USSTR-Avionics/MiniRockets/Software/CPP_flight_computer_program/PREFLIGHT_CHECKLIST.md

- [ ] Check orientation of sensors and correct configuration in code

- [ ] Run unit tests on OBC

- [ ] Commit and release package

- [ ] Run unit tests and upload to OBC

- [ ] Build code in production mode and upload to flight computer
