USSTR-Avionics/MiniRockets/Software/CPP_flight_computer_program/documentation/GLOSSARY.md

Apogee: 
    the highest point the rocket will reach

OBC: On Board Computer (used interchangeably with Flight Computer)
    The main microcontroller/computer that controls all the electronics on the rocket
