USSTR-Avionics/MiniRockets/(threads)

Thread 13 (2022-10-29):

statemachine vulnerability

snowy-shadow, 2022-10-29:
please replace the statemachine with a
```
namespace xyz
{
    enum class abc
    {
      states
    }
}
```
Always prefer enum class over enum

frroossst, 2022-10-29:
Will fix after migration to CPP is complete! And MVP code for a mini rocket is complete.

Expected completion date : 30 November 2022

frroossst, 2022-10-30:
Enum classes not supported by C!

Our cpp should maintain compatibility with core C, to keep the code portable for future micro controller changes. Might reopen this later.

snowy-shadow, 2022-10-30:
`enum` is supported by C. problem is
```
enum States
{
a,
b
}
```
`a == 0` is evaluated true, which is another vulnerability which `enum class` fixes
this means `if(states == a)` is the same as `if(states == 0)`

frroossst, 2022-10-30:
wouldn't this help solve the issue you mention? Now every state will be valid only once
```
 #include<stdio.h>

  enum state{Ground, Flight, Landed};

  int main()
  {
      enum state s;

      s = Ground;
      printf("%d \n",s);
      return 0;
 }

```

snowy-shadow, 2022-10-31:
that is the main idea yes. we want to only allow one state to exist at a time so
```
state
{
   state1,
  state2,
}
state s = state1;
func(s);
func2(s);
```
is one way to prevent having 2 states happening at the same time.
there are also fancier implementations that I've seen(with pointers and classes, for C, it would be with void ptrs and structs), but for our purpose it would suffice here i think.
I could look more into FSM designs since im also interested in using them in my own projects

frroossst, 2022-10-31:
I agree it is quite dumb to use a struct for the actual state than enum, as multiple states would not be valid at the same time, we can probably blame @djh293 for that lol

yes! and in our current design we can also conceivable set the wrong states
```
rocketstate.landed = true;
rocketstate.flight = true;
```
A simple error or oversight in copy pasting code would lead to some major problems

snowy-shadow, 2022-11-02:
I got the statemachine figured out, im going to start working on the statemachine if there are no other urgent tasks

this is the most elegent version of statemachine that I could find on the internet...

Here is the proof of concept:
https://godbolt.org/z/zonscWdPW

frroossst, 2022-11-02:
Hold off on it for now. Dylan and I have different priorities right now. We're working out some managerial kinks on the project.

Closed 2022-11-09.

Thread 16 (2022-10-31):

Fix .gitignore

frroossst, 2022-10-31:
This is my bad, I was dumb, my updated `.gitignore` was in `Avionics-code/CPP.....` while the top level directory was `Avionics-code/` I'll have to go in and `git rm <name>` things now.

The following is a thread documenting things we NEED to be ignored.

- Compiled Rust target binaries
- IDE specific folders (.vsc etc)

frroossst, 2022-11-01:
I have fixed this on my end.

Closed 2022-11-29.

Thread 18 (2022-11-02):

I got the statemachine figured out / Statemachine redesign / rewrite

snowy-shadow, 2022-11-02:
I got the statemachine figured out, allow me to fix our statemachine

this is the most elegent version of statemachine that I could find on the internet...

Here is the prototype:
https://godbolt.org/z/zonscWdPW

Closed 2022-11-02.

Thread 28 (2022-12-17):

Add code for I2C Thermocouple sensor

frroossst, 2022-12-17:
- Prototype by itself
- Add it to main() codebase

frroossst, 2023-02-05:
Intitial code: https://github.com/USSTR-Avionics/Avionics_code/pull/52

Closed 2023-02-12.

Thread 30 (2022-12-24):

Change (debug == true) checks to a defined macro

frroossst, 2022-12-24:
For optimal performance instead of doing a branched check we just do macro substitution using the pre-processor

```
// define a macro
#define println(a) Serial.println(a)

// write a debug print
println("Hello world!");

// disable the macro on production
#define Sprintln(a)

```

frroossst, 2023-01-16:
Only make these changes to the src/ folder

frroossst, 2023-01-16:
fixed with https://github.com/USSTR-Avionics/Avionics_code/tree/958f1e9244c95f15e3bb4d8336b7f7f4283a0771

Closed 2023-01-16.

Thread 31 (2023-01-15):

Add silk screen pin labels to the PCB

frroossst, 2023-01-15:
To easily identify pins that connect to the flight computer

frroossst, 2023-03-23:
Design was frozen, never implemented!

Closed 2023-03-23.

Thread 33 (2023-01-16):

Add diode and switch before power branches out to components

frroossst, 2023-01-16:
- To have a global switch to the entire system
- To prevent someone from plugging in the battery the wrong way around

Closed 2023-03-23.

Thread 34 (2023-01-16):

RFC 202301181937: Resume state on software crash

frroossst, 2023-01-16:
The rocket if the software crashes should resume in the state it was last in, or implement a recovery mode

frroossst, 2023-01-19:
# Abstract

If the rocket's software crashes, how do we ensure it picks up or resumes the state machine from
the position it left it in. We cannot restart as if software crashes on ballistic descent, and we
restart from ground idle then we'll never transition forward and ever reach parachute deploy, due
to how the parameters in the state machine handle transitions.

# Stakeholder(s)

Avionics

# Problem

If the rocket's software crashes, how do we ensure it picks up or resumes the state machine from
the position it left it in. And to resume and ensure a successful flight.

# Solution(s)

## Store the state in the FRAM

Store the state in a single byte on the FRAM after every transition and pickup state from where it
crashed.

## Enter a software recovery or safe mode of sorts

On watchdog timeout simply enter a safe mode where the rocket enters a recovery or safe mode where
it only focuses on the essential software tasks, such as deployment of the recovery system, and nothing
more, may send a panic!() radio signal to the ground station.

# Difficulties and Risks

## Store the state in the FRAM

The potential problem with this is if the software crashes after a state transition but
before a successful FRAM write then we're stuck in a state from which we cannot get out of. Another
problem is that we may not have a solid I2C bus to the FRAM, so we may not be able to write to it or
loose it mid-flight. This also puts a single point of failure on the FRAM.

## Enter a software recovery or safe mode of sorts

This is a more complicated solution, but it would allow us to recover from a software crash and
resume the state machine from where it left off. This would require a lot of work and testing to
ensure that we can recover from any state and resume the state machine from where it left off. We
need to ensure that the recovery system doesn't have a single point of failure, for example, what
would we do if the barometric sensor(s) fail. Refer to [RFC: Sensor redundancy](https://github.com/USSTR-Avionics/Avionics_code/issues/36)

# Estimated costs and timelines

There should be no cost associated with this, as it is a software solution.

Timeline for solution 1 is a couple of days at best, while solution 2 may require a couple of weeks
as we haven't yet been able to configure the watchdog timer to trigger a reset on time.

# Proof of Concept

Not Applicable

# Testing and Robustness assurance

test, Test, TEST, T E S T !

# References
Not Applicable

casey-SK, 2023-01-21:
You need to be careful to ensure the correct state is entered. Gotta make sure you don't ignite the rocket motor at an unsafe time just because the software previously crashed. If the program crashes, I would probably not attempt to recover and put it in "super safe mode" where no code is allowed to execute, period.

The solution to this problem is have good coverage and anticipate all errors.

frroossst, 2023-01-21:
When the rocket first boots up, it enters an "unarmed stage" where it does nothing, literally nothing except wait for a radio signal from the ground telling it to arm itself, after it is armed, it can fire rocket motors and then it transition to powered flight -> unpowered flight -> ballistic descent -> parachute deploy -> land safe.

As for the rest, I can get you on speed tomorrow! :)

frroossst, 2023-02-19:
Already implemented software_recovery_mode in 28928d774e22ca764ae01d6f633a490f8b51f9ee

snowy-shadow, 2023-02-23:
```
void setup
{
rocket_state = eeprom.read(0x00)
}

void loop()
{
stuff
}
```
for each rocket statechange, write to the eeprom as in integer. Instead of `void recover()`, just get state from the eeprom everytime you run setup which would be run when the board crash

snowy-shadow, 2023-02-23:
https://www.pjrc.com/teensy/td_libs_EEPROM.html
teensy 4.1 have 4284 bytes of eeprom

Closed 2023-04-15.

Thread 36 (2023-01-16):

RFC 202301181940: Sensor redundancy/ Handle a mission critical sensor failure

frroossst, 2023-01-16:
Handle the failure of an acceleration sensor and a barometric pressure sensor

frroossst, 2023-01-19:
# Abstract

If the rocket's software crashes, how do we ensure it picks up or resumes the state machine from
the position it left it in. We cannot restart as if software crashes on ballistic descent, and we
restart from ground idle then we'll never transition forward and ever reach parachute deploy, due
to how the parameters in the state machine handle transitions.

# Stakeholder(s)

Avionics

# Problem

If the rocket's software crashes, how do we ensure it picks up or resumes the state machine from
the position it left it in. And to resume and ensure a successful flight.

# Solution(s)

## Store the state in the FRAM

Store the state in a single byte on the FRAM after every transition and pickup state from where it
crashed.

## Enter a software recovery or safe mode of sorts

On watchdog timeout simply enter a safe mode where the rocket enters a recovery or safe mode where
it only focuses on the essential software tasks, such as deployment of the recovery system, and nothing
more, may send a panic!() radio signal to the ground station.

# Difficulties and Risks

## Store the state in the FRAM

The potential problem with this is if the software crashes after a state transition but
before a successful FRAM write then we're stuck in a state from which we cannot get out of. Another
problem is that we may not have a solid I2C bus to the FRAM, so we may not be able to write to it or
loose it mid-flight. This also puts a single point of failure on the FRAM.

## Enter a software recovery or safe mode of sorts

This is a more complicated solution, but it would allow us to recover from a software crash and
resume the state machine from where it left off. This would require a lot of work and testing to
ensure that we can recover from any state and resume the state machine from where it left off. We
need to ensure that the recovery system doesn't have a single point of failure, for example, what
would we do if the barometric sensor(s) fail. Refer to [RFC: Sensor redundancy](https://github.com/USSTR-Avionics/Avionics_code/issues/36)

# Estimated costs and timelines

There should be no cost associated with this, as it is a software solution.

Timeline for solution 1 is a couple of days at best, while solution 2 may require a couple of weeks
as we haven't yet been able to configure the watchdog timer to trigger a reset on time.

# Proof of Concept

Not Applicable

# Testing and Robustness assurance

test, Test, TEST, T E S T !

# References
Not Applicable

frroossst, 2023-01-19:
# Abstract

Handle the failure of a mission critical sensor, off the top of my head acceleartion and barometric
sensor failure would be the most critical.  The system should be able to reliably state transition
and/or deploy the recovery system.

# Stakeholder(s)

Avionics

# Problem(s)

How do we know
a) the values from the sensor are valid and reliable in refernece to the environment
b) recover from a sensor failure or a failure to communicate, or loss of sensor data

# Solution(s)

a) use multiple sensors and compare the values

b) Kalman filter to estimate the state of the system

c) use a sensor fusion algorithm to combine the sensor data

d) in case of complete sensor failure?!

Looking for feedback!

# Difficulties and Risks

a) how to select the correct sensor reading when multiple sensors report different values

b) how to implement and test the validity of the Kalman filter

c) how would we even go about doing this?

d) I think we just give up at this point.

# Estimated cost(s) and timeline(s)

with research and development and standard USST work hours we're looking at a 4-6 weeks, at least.

# Proof of Concept

Not Applicable

# Testing and Robustness Assurance(s)

Looking for feedback!

# Reference(s)

Not Applicable

snowy-shadow, 2023-01-19:
Im proposing
3 sensors, after applying EMA on each values, make sure they lie within a certain % of each other. The one that doesn't gets a strike and is excluded in the currently calculation.
If accumulated a certain amount of strikes within a certain period, the sensor is deemed broken and ignored or turned off
else the strike is reset

frroossst, 2023-01-19:
Would we have 3 different sensors? or 3 of the same kind?
- I feel 3 of the same makes more sense, as if they are from the same manufacturer then we can eliminate a lot of variables between ICs, manufacturers etc.

How would we go about determining that margin of error percent?
- Off the top of my head, a lot of trial and error is what comes to mind. It'll be a balancing act for sure

snowy-shadow, 2023-01-20:
1. 3 of the same sensor would be the bare minimum for detecting if 1 of the sensor is faulty
2. Yes, trial and error honestly

frroossst, 2023-01-20:
Let's say we mark a sensor as faulty, so now we're working with 2/3 sensors (this is assuming we have implemented the 3 strikes system to increase our odds of NOT getting a false positive), now working with 2 sensors, what if we get a discrepancy then, i.e. our two remaining sensors don't align. Would we get an input from the sensor we marked supposedly "faulty" to see which of our two current sensor is giving us a value that might be closer to the actual reading. Or would we enter a loop where we take the readings again 3 times and compare, if all 3 readings are outside a margin of error, we declare acceleration sensors as bonked and enter a state or solution that would be implemented in RFC https://github.com/USSTR-Avionics/Avionics_code/issues/34

Now admittedly this is a rare issue, that we would not be encountering on the actual flight, but just something we should discuss and think about before we move on with a potential implementation

casey-SK, 2023-01-21:
I enjoy this thought experiment and would also be proud to have developed such a robust system. However, I don't believe sensor redundancy is required for this project.

Correct me if I am wrong, but the goal of the Rocketry team is to launch a single stage solid rocket to >10,000 ft ? I think there is a payload requirement, or is the payload optional?

Anyways, After igniting the solid rocket motor, the avionics only really has 3 vital jobs

1. Measure altitude and store that value. (we don't even technically need all the values, we only need to know the apogee)
2. Deploy the parachute on decent
3. Emit a recovery signal so we can recover the rocket

Obviously, we will be doing a lot more than this, but it is important to remember the KISS principle.

Getting back to the sensor redundancy, only one sensor is vital and the rest are 'bonus': Pressure. At a bare minimum, we can use the [NOAA](https://en.wikipedia.org/wiki/Pressure_altitude) formula to estimate the altitude. Provided the sensor has been tested before launch day, it is highly unlikely it will fail to provide a result. Just as critical as the sensor is the storage. Are we gonna propose redundant storage as well? How many cpu cycles do we got to spare to do multiple writes?

I am just walking in the door, so I don't know this, but I am assuming our avionics will include a GPS module onboard? We can use that to back up the claims made by our pressure sensor or trust the data in the absence of the pressure data if it were to fail.

Additionally, we could use radio time of flight to get a range as well, with a little help from our friend Pythagoras we can derive altitude. So we now have 3 methods to come up with an altitude reading without adding more sensors on board.

Cheers.

djh293, 2023-01-21:
There is a valid justification for implementing redundant sensors given in Launch Canada's Requirements that we need to be designing towards:

"Launch vehicles shall implement completely independent and redundant recovery systems,
including:
• Arming switch
• sensors/flight computers
• power supply
• energetics
• ""electric initiators"""

With that being said, the purpose of the first mini-rocket test launch is to demonstrate a minimum viable product (MVP) witch has only 2 vital jobs mentioned above for the mini-rockets:
1. Detect apogee
2. Deploy the parachute

With the KISS principle in mind, I believe as long as we thoroughly test the sensor on the ground, we do not have a high risk of losing that data.

Therefore, for this first MVP launch, we should only have one thoroughly tested sensor. For Launch Canada this should be discussed further.

Closed 2023-04-15.

Thread 37 (2023-01-18):

Figure out a testing (unit/integration) framework for testing the whole system including the hardware

frroossst, 2023-01-18:

casey-SK, 2023-01-21:
https://docs.platformio.org/en/latest/advanced/unit-testing/index.html#unit-testing

frroossst, 2023-01-21:
Our problem is that we can't really run the code that interfaces with the hardware on our machines without the actual hardware.

For example how would we go about, testing the acceleration sensor works correctly.

casey-SK, 2023-01-21:
I  would perform a resistance test to ensure all pins work on a given IC, perform a bench test on an apparatus where you can control the parameter in question (a drop test for the linear acceleration example, comparison test for most other sensors), and use a debugger probe to to test the code in situ.

frroossst, 2023-01-21:
Perhaps we can lay this test plan out tomorrow! And get onto laying out procedures on how to perform them and building apparatus to test our systems. I was looking at mainly software solutions like fuzz testing perhaps cause software is what I'm most familiar with.

frroossst, 2023-01-21:
Haven't looked into this a lot, but I'll try to get a proof of concept up and running by next week, we could using an additional micro-controller hijack the I2C lines and emulate the data received from the sensors, this would allow us to test a variety of scenarios really quickly and make fuzz testing fairly simple too.

frroossst, 2023-03-23:
Moved to the Delisle project!

Closed 2023-03-23.

Thread 38 (2023-01-18):

[Example] RFC: Why not just make a nuclear missile?

frroossst, 2023-01-18:
*This is an example RFC, we're not actually gonna build a nuclear missile*

# Abstract

Instead of making a model rocket going 30,000 feet, we could just make a nuclear missile

# Stakeholder

Propulsion, Avionics, Aerostructure, P&E, Payload

# Problem(s)

Not Applicable/ Looking for comments

# Solution

Not Applicable/ Looking for comments

# Difficulties and Risks

- Thrust Vector Control and control surfaces
- Nuclear payload development
- Procurement and enrichment of uranium
- Disposal of nuclear waste
- No one on the team is a nuclear physics expert or remotely capable on the subject

# Estimated costs and timelines

A couple of billion dollars and about 30 years

# Proof of concept

The government told us to redact this part

# Testing and robustness assurance

Looking for comments

# References

Not Applicable

Closed 2023-04-15.

Thread 48 (2023-01-29):

[Thread] Sensors are giving out garbage values

frroossst, 2023-01-29:
I was testing the Teensy with only the BMP280 and KX134 and the sensors are giving out garbage values, am figuring out if it is a Teensy issue, a sensor issue or a code issue. Most probable is a sensor issue, but they're new so ¯\_(ツ)_/¯

ping: @djh293

frroossst, 2023-01-29:
I2C Scanner says no I2C devices found.

```
Unknow error at address 0x01
Unknow error at address 0x02
Unknow error at address 0x03
Unknow error at address 0x04
Unknow error at address 0x05
Unknow error at address 0x06
Unknow error at address 0x07
Unknow error at address 0x08
Unknow error at address 0x09
Unknow error at address 0x0A
Unknow error at address 0x0B
Unknow error at address 0x0C
Unknow error at address 0x0D
Unknow error at address 0x0E
Unknow error at address 0x0F
Unknow error at address 0x10
Unknow error at address 0x11
Unknow error at address 0x12
Unknow error at address 0x13
Unknow error at address 0x14
Unknow error at address 0x15
Unknow error at address 0x16
Unknow error at address 0x17
Unknow error at address 0x18
Unknow error at address 0x19
Unknow error at address 0x1A
Unknow error at address 0x1B
Unknow error at address 0x1C
Unknow error at address 0x1D
Unknow error at address 0x1E
Unknow error at address 0x1F
Unknow error at address 0x20
Unknow error at address 0x21
Unknow error at address 0x22
Unknow error at address 0x23
Unknow error at address 0x24
Unknow error at address 0x25
Unknow error at address 0x26
Unknow error at address 0x27
Unknow error at address 0x28
Unknow error at address 0x29
Unknow error at address 0x2A
Unknow error at address 0x2B
Unknow error at address 0x2C
Unknow error at address 0x2D
Unknow error at address 0x2E
Unknow error at address 0x2F
Unknow error at address 0x30
Unknow error at address 0x31
Unknow error at address 0x32
Unknow error at address 0x33
Unknow error at address 0x34
Unknow error at address 0x35
Unknow error at address 0x36
Unknow error at address 0x37
Unknow error at address 0x38
Unknow error at address 0x39
Unknow error at address 0x3A
Unknow error at address 0x3B
Unknow error at address 0x3C
Unknow error at address 0x3D
Unknow error at address 0x3E
Unknow error at address 0x3F
Unknow error at address 0x40
Unknow error at address 0x41
Unknow error at address 0x42
Unknow error at address 0x43
Unknow error at address 0x44
Unknow error at address 0x45
Unknow error at address 0x46
Unknow error at address 0x47
Unknow error at address 0x48
Unknow error at address 0x49
Unknow error at address 0x4A
Unknow error at address 0x4B
Unknow error at address 0x4C
Unknow error at address 0x4D
Unknow error at address 0x4E
Unknow error at address 0x4F
Unknow error at address 0x50
Unknow error at address 0x51
Unknow error at address 0x52
Unknow error at address 0x53
Unknow error at address 0x54
Unknow error at address 0x55
Unknow error at address 0x56
Unknow error at address 0x57
Unknow error at address 0x58
Unknow error at address 0x59
Unknow error at address 0x5A
Unknow error at address 0x5B
Unknow error at address 0x5C
Unknow error at address 0x5D
Unknow error at address 0x5E
Unknow error at address 0x5F
Unknow error at address 0x60
Unknow error at address 0x61
Unknow error at address 0x62
Unknow error at address 0x63
Unknow error at address 0x64
Unknow error at address 0x65
Unknow error at address 0x66
Unknow error at address 0x67
Unknow error at address 0x68
Unknow error at address 0x69
Unknow error at address 0x6A
Unknow error at address 0x6B
Unknow error at address 0x6C
Unknow error at address 0x6D
Unknow error at address 0x6E
Unknow error at address 0x6F
Unknow error at address 0x70
Unknow error at address 0x71
Unknow error at address 0x72
Unknow error at address 0x73
Unknow error at address 0x74
Unknow error at address 0x75
Unknow error at address 0x76
Unknow error at address 0x77
Unknow error at address 0x78
Unknow error at address 0x79
Unknow error at address 0x7A
Unknow error at address 0x7B
Unknow error at address 0x7C
Unknow error at address 0x7D
Unknow error at address 0x7E
No I2C devices found
```

frroossst, 2023-01-29:
Apparently using the ground pin on the right hand side while also having 3v3 and 5v plugged in doesn't work?! and you need to use the ground on the other side of the board, this stops the unknown error warnings, but still no I2C devices show up

frroossst, 2023-01-30:
After some panic, I think I know what went wrong here, will do more testing and confirm by EOD

frroossst, 2023-01-30:
Sensors work as intended, false alarm.

Didn't solder the power and I2C pins properly on the teensy, smh.

Closed 2023-01-30.

Thread 53 (2023-02-05):

RFC 202302061040: Communication Between Systems

dhaussecker, 2023-02-05:
# Abstract
We need to come to a conclusion about a communication method for our systems to talk to each other. There are multiple serial communication methods that could be utilized: Some popular ones that always come up are I2C, SPI, and CAN. What's best and what should we choose?

# Stakeholder(s)

Avionics
Propulsion
Aerostructure
Systems

# Problem(s)

We need to decide on a communication protocol to be used across systems in the rocket

# Solution(s)

a) I2C
Requires one specific device to be the master.
Lines: 2 lines [SCK and SCL]
Speed: 100kbps
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

b) SPI
Requires one specific device to be the master
Lines: 4 lines [MISO, MOSI, SCK, CS], Must add extra CS for each additional sensor
Speed: up to 10Mbps
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

c) CAN
In CAN each node can behave as Master or Slave. Has a device/message priority system.
Lines: 2 Lines[TX and RX]
Speed: up to 1 Mbit/s
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

d) Other Communication Methods (Ethernet, Fiber Optic, USB, UART)
- Make a proposal if you can think of any other options

Looking for feedback!

# Difficulties and Risks

a) Need to decide what method will be best for us

b) I2C is not at all the way to go for long distances. CAN transceivers or RS485 used with normal UART is a robust solution. I2C is designed to be used in-PCB so max distance shouldn't exceed 50 cm. SPI's maximum distance is about 10m. CAN's max distance is about 1km

c) SPI wiring gets more complex for each new sensor you add in as each sensor requires one new wire, wire I2C and SPI don't.

d) SPI can't acknowledge that data has been successfully received (I2C and CAN have this)

c) Multiple student rockets are using CANbus for their systems, making it seem like a good way to go, but I don't want to just jump into it without other input.

# Estimated cost(s) and timeline(s)

This system would be integrated in all board and software designs throughout this year.

# Proof of Concept

Check references for Uwaterloo's CANbus architecture

# Testing and Robustness Assurance(s)

Looking for feedback!

# Reference(s)

https://drive.google.com/open?id=169TVnTIVYmfNrPiK4FvcD331LEPFN7fr&disco=AAAAm5xzJQI

frroossst, 2023-02-05:
We have I2C and SPI sensors, how would we convert them to the CAN protocol? Are there sensors that are CAN compatible already which we can use? How complex is the process of converting from (I2C, SPI) to CAN.

Before making the decision, we should convert the basic groupings of sensor, (BMP280, KX134, FRAM) and use them over CAN with the Teensy as a proof of concept.

If CAN turns out to be expensive in terms of time, energy and code  to implement, could we feasibly use CAN for sensors that require long distance communication and I2C for others?

djh293, 2023-02-06:
This discussion mainly revolves around communications between systems, and by between systems, I mean between our boards. Note, this does note include communications within each board.

All the sensors mentioned above will still use I2C or SPI, weather to use  I2C or SPI within the board should come down to what is deemed the most critical, and could be a further discussion (SPI is faster than I2C). CAN-bus would only be used to communicate from board to board using a CAN transceiver hooked up to the microcontroller on the board.

See the photo of the proposed gps board as an example as it has the proposed CAN-transceiver:
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

frroossst, 2023-02-06:
So, if I understand this correctly, then CAN would be used for let's say communicating between the microcontroller on the GPS board, the microcontroller on the RF board, and let's say the main microcontroller? Wouldn't this mean that a microcontroller is required on every individual/ modular board we add to the mix? Does this no unnecessarily raise the complexity of the system? Why add one more serial communication interface? (except maybe the distance issue with I2C and SPI)

djh293, 2023-02-06:
This is a 10 foot tall rocket we are talking about. There is going to be a need for some boards to be closer to one side of the rocket than the other.

Also it does not complicate the problem in my opinion, it simplifies it. All systems are now on their own individual board. It would be a nightmare if you had to redo a whole entire board when all you needed is to add one extra part. Also, one microcontroller for everything is not feasible for the amount of wires that would have to be running to it for every single sensor. Serial communication just simplifies the problem by allowing that data to be transferred over 2 wires instead of let’s say 100. A single microcontroller controlling every single subsystem would very quickly become an issue

frroossst, 2023-02-06:
I think the different board and communication arguments make sense. I think the modularity would be a huge boon in the long term, it also allows some boards to be asynchronous if we have a datalogger board that just listens to I2C signals on a line then it wouldn't be "blocking" the main flight computer and doing this with other boards would also free up the main loop() and make it faster, just a few clarifying questions though, would we standardise what microcontrollers are used across different baords or would that be left to the board designers? I think it should be left to board designers, for example the GPS board would definitely need hardware float support, whereas the FRAM board doesn't necessarily need as powerful a computer on it's module board. Also, are we concerned about the delay that is added by introducing a microcontroller in the middle?

Current: `main micro-controller` -> `sensor`
Planned: `main micro-controller` -> `modular micro controller` -> `sensor`

djh293, 2023-02-07:
I am not concerned with any sort of delays, sensors go to their mcu on the board then straight to CAN, that’s actually going to make things faster than using 1 mcu for everything. Mcu type would will likely be standardized (for example we will be testing out STM32’s) but particular mcu part numbers could be modified for certain applications.

frroossst, 2023-02-07:
I only mention the slowdown because if you were building a self-driving card having a central powerful gpu is more faster and efficient than having multiple gpus process at the sensors before they reach the main micro-controller. Are we concerned about the costs? For some applications the standard mcu might be overkill and not worth the cost? Is there an actual difference in the amount of money these different mcus cost?

djh293, 2023-02-07:
Our standard mcu is only $5, so I’m not concerned about the cost (other options could range between $1-$20. We not planning to  design the fastest system on the planet so there is no need to optimize the system to be as fast as possible, although I see no risk in slowing down speeds anyways.

frroossst, 2023-02-07:
If that's the case then, I don't see any problems at least now, that might arise from this implementation.

Closed 2023-04-15.

Thread 57 (2023-02-18):

Fix blocking code in main program

dhaussecker, 2023-02-18:
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
Please fix the following lines of code to have a non-blocking implementation

frroossst, 2023-02-18:
I don't get paid enough to deal with this shit

frroossst, 2023-02-18:
How do we ensure non blocking implementation of the above, does not break soft_recovery_mode()

https://github.com/USSTR-Avionics/Avionics_code/blob/239cbfb9d4ad30f8ef577375a49e0b4af8b44a7f/CPP_flight_computer_program/src/main.cpp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

frroossst, 2023-02-22:
|      data            |   size    | data type |
|----------------------|-----------|-----------|
| time                 | 04 bytes  | u32       |
| rocket state         | 01 byte   | u8        |
| acceleration x axis  | 02 bytes  | float16   |
| acceleration y axis  | 02 bytes  | float16   |
| acceleration z axis  | 02 bytes  | float16   |
| gyroscope x axis     | 02 bytes  | float16   |
| gyroscope y axis     | 02 bytes  | float16   |
| gyroscope z axis     | 02 bytes  | float16   |
| relative altitude    | 02 bytes  | float16   |
| pressure             | 02 bytes  | float16   |
| thermocouple temp    | 02 bytes  | float16   |
| extra space          | 02 byte   | undefined |
| total                | 25 bytes  |           |

> I've used collect and store interchangeably here, please note, collection here refers to collection to the fram i.e. storage to the fram

Say, this is what one sensor chunk looks like, takes up 25 bytes, 2 bytes are reserved for whatever extra data that we might need to store in the future, maybe payload info, or thermocouple internal temperature or anything really, I've kept it as 2 bytes (could be more).

Now our fram can store 32Kbyte(s) which is 32,000 bytes. now, one chunk of data is 25, so we'll be able to write $$32,000/25 = 1,280$$

So, we can write to one FRAM 1280 chunks of data. so far so good.

If we write 1 chunk per second, we'll be able to collect data for 1280 seconds which is 21.33 minutes.

But, as the preliminary testing over discord the other day suggested, our loop() executes about 500 times in every other state with the exception of the aforementioned state (~2) and ground_idle (>2000).

Now, even if I were to assume that we're collecting data 250 times a second which is half of what the expected tick rate for loop() is, we'll be able to collect 5 seconds worth of data.

Assuming we're collecting data every 100 times a second, which is 20% of the nominal loop() tick rate, we'll be able to collect 12.8 seconds worth of data

Assuming we're collecting data 2 times a second, this gives us 640 seconds worth of flight data, which is roughly 10 minutes, if we double to rate i.e. collect data 4 times every second, gives us 5 minutes or so of flight data.

Now, a simple solution is to add more FRAM if you want to keep up the high tick rate of data collection *cum* storage, you'd need to have **60 FRAMs to store about 5 minutes worth of data, at a tick rate of 250 per second**, so naturally the other solution is to slow down the tick rate, by how much you might ask? well, about 2 per second, would be my recommendation, strikes a balance between the data we collect, and the storage we have without needing to add additional storage. And this "blocking" loop accommodates that requirement with zero modifications.

---
So, the conclusion is I will not be modifying this specific part of the code to be non-blocking for the time being and with the current hardware limitations, as under no circumstances at least with respect to data collection can this be considered ''blocking", if someone has a better argument apart from ''we need data in the meanwhile" which as demonstrated above is a fairly smooth brained take, and "while true bad" which demonstrates a lack of understanding of how code actually works and interacts with the system at large, if your argument is "we need the data for *something*" then I need to see a MVP or proof of concept of that *something* that you're referring to, making premature optimizations for phantom *somethings* is NOT something we should be wasting our time on.

If you have other arguments then please leave them down below in the thread!

dhaussecker, 2023-02-23:
"as under no circumstances at least with respect to data collection can this be considered blocking"
With respect to data collection, this may be true it's not going to impact us, but to respect to the whole entire system, it's going to impact us long-term.

Blocking code will make it EXTREMELY difficult to expand our system in the future, and I guarantee you this if you're writing not proper code right now with your excuse being "we don't need it right now" it will have to be rewritten in the future and waste more time.

There is an easy way to fix this, just use the same implementation we are using with tracking time using millis(), to remove the blocking part of the code. This is an easy fix, it will impact a few other functions that you will have to take into account but it is better than impacting 100 functions down the road when you realize your blocking code is holding you back a year from now. If you don't get to this, I'll fix it within the next couple of weeks.

"Write proper code now, so you do not have to 1 year from now" -Dylan ;)

frroossst, 2023-02-23:
I'm upset cause your whole argument was data collection :sob: :sob: :sob:

Blocking code is problematic if and only if you need to be doing something in the meanwhile, which we are not (right now), in the future perhaps, but like, what even would we be doing? We'll get to this when we do radio integration (even then we might not need to)

dhaussecker, 2023-02-23:
The fix for this will take 20 minutes, yet this discussion has taken multiple hours. Let’s just fix it when we have the time

frroossst, 2023-02-23:
Because it very much matters the path you take to a solution on a team project, as the "true" intentions might be masked behind a bs reason.

For example, the decision to switch from I2C to CANbus, could be justified as speed restrictions of I2C and it would be a perfectly reasonable explanation, but, the actual reasoning is length restrictions of I2C and the increased flexibility with CANbus with priority queues.

If someone is referencing these threads in the future, we're providing them with not actual truths behind our decisions, and if not for future-proofing we're propagating falsities through the team. This just creates a bad habit which'll result in something catastrophic down the line, let's say like buying a 20,000 dollar camera which does not work with the OBC 0_o

dhaussecker, 2023-03-08:
Code is still blocking, removing the while true in apogee check will conics me it is not

frroossst, 2023-03-08:
technical analysis of the impact or it didn't happen!

Closed 2023-04-15.

Thread 65 (2023-03-12):

Setup a remote dev workflow for devs to run code and unit tests remotely

frroossst, 2023-03-12:

snowy-shadow, 2023-03-13:
should we merge this with the ducklake proj? Both needs a server connection, and will read from the serial port. Both will need a webpage front end, and we might as well include a simple login to avoid random people visiting the site and taking over the arduino.

frroossst, 2023-03-13:
Yes and no.

Yes, because of all the reasons you mentioned

No, because DuckLake if things pan out wouldn't end up requiring a server, that whole setup was a little too much, PlatformIO has some remote development workflows we might end up going with that rather than building some infra ground up. (although would love to do that) now, we'd probably end up making some sort of credential manager to avoid people running random code on our remote dev servers.

We basically have three projects as of now:
| Project Name | Description | Priority |
|--------------------|----------------|------------|
| Duck Lake | Visualise Rocket Data | Low |
| Esterhazy|  Remote dev/ run tests | Moderate |
| Delisle | Software in the Loop tester | High |

We'll work on Delisle to get the whole software in the loop system going and then work on Esterhazy to use the whole system remotely, we might be able to do some Esterhazy work and then add on more features later, and Duck Lake will be very low on our list, as I cannot find someone to write some React code as of now.

snowy-shadow, 2023-03-13:
Thats great news! I just googled platformio remote dev and it seems super easy to setup (fingers crossed)

frroossst, 2023-03-23:
Moved to the [Esterhazy](https://github.com/USSTR-Avionics/Esterhazy) project

Thread 70 (2023-04-01):

The Future of Aviation: Why Rewriting Our Avionics Codebase in Rust is Essential for Success

frroossst, 2023-04-01:
Ladies and gentlemen, gather 'round and brace yourselves for the most audacious, grandiloquent, and downright impressive proposal you will ever encounter. Today, I present to you a compelling case for rewriting our avionics codebase in Rust, a language so cutting-edge it would make Elon Musk himself drool with envy.

Now, I know what you're thinking. "Why fix something that ain't broke?" But hear me out, dear colleagues. Our current codebase may be functioning as intended, but it lacks the resilience, robustness, and performance necessary to keep up with the demands of modern avionics. It's time to step up our game and embrace a language that can handle the challenges of the future.

With Rust, we can achieve unparalleled speed and efficiency, thanks to its low-level control over system resources and memory management. No more will we be bogged down by the overhead of dynamic memory allocation and garbage collection. Rust's strict compiler checks ensure that we catch errors before they become disasters, and its unique ownership model prevents the dreaded bugs caused by dangling pointers and data races.

But that's not all, folks. Rust is designed for concurrency, making it the ideal choice for handling the multiple tasks and systems required for aviation. Its lightweight threads and fearless concurrency model allow us to tackle the complexity of modern avionics with ease. And don't even get me started on Rust's security features. With its built-in memory safety and protection against buffer overflows, we can rest assured that our codebase is resistant to cyber attacks and other malicious exploits.

Now, I know some of you may be thinking, "But what about the learning curve? Won't we have to retrain our entire team?" Fear not, my friends. Rust's syntax is easy to learn and understand, and its community is vibrant and supportive. We can even integrate Rust with our existing codebase, making the transition seamless and painless.

In conclusion, dear colleagues, we owe it to ourselves, our passengers, and the future of aviation to rewrite our avionics codebase in Rust. It's time to embrace the future, and Rust is the language that will take us there. So let's do this. Let's rewrite our codebase in Rust and take to the skies with confidence and pride.

dhaussecker, 2023-04-01:
Please fill out a project proposal if you are actually wanting to propose this. The core foundation of weather a project will be approved is the following: "do the simplest thing that can possibly work". If it is determined that this is not the simplest thing that could possibly work, it is not worth our time with our intense schedule coming up over the next year.

At this point I do not see any merit in porting over our entire codebase to Rust when we have something that already works. We are not trying to meet the needs of modern avionics, we are a student team trying to develop a whole entire system within a year. Our core principle is, to do the simplest thing that can possibly work to make this happen.

Project Proposal template can be found here: https://github.com/USSTR-Avionics/KnowledgeBase/wiki/Documentation-Templates#project-proposals

frroossst, 2023-04-02:
# Background and Motivation

Rust is an excellent choice for an avionics project because of its safety features and low-level control. In the aerospace industry, safety is critical, and Rust's ownership model and strong typing help avoid common programming errors such as null pointer de-references, buffer overflows, and data races that can lead to system crashes or vulnerabilities. Rust also has a small runtime footprint and can produce efficient code, which is essential for embedded systems with limited resources.

Furthermore, Rust's support for bare-metal programming makes it well-suited for avionics projects that require direct hardware access. Rust's syntax and semantics allow for low-level memory manipulation, and its zero-cost abstractions make it possible to write efficient code without sacrificing control.

#   Why is this valuable to work on?

Well, for so many reasons, firstly, it’s just more modern, modern c++ is nothing more than a hot pile of garbage over another hot pile of garbage. Don’t get me wrong, I love C and C++, and I will happily code in them over Java or Javascript. But, when we have a group of people working on performance critical and robust systems where we cannot ensure or assume that every member of the team knows what they are doing, we run into a problem. Now, this could very easily be solved, we just hire someone who does QA, well maybe not hire but just assign them the title, but even the best programmers are no match for the Rust compiler, which can within seconds tell you what you are doing wrong. And it tells you at compile time, meaning, with proper CI/CD (which is basically a compile check) it is impossible (literally!) to commit code to master that has memory bugs in it!

And as an additional bonus we have seen a massive push towards Rust from the industry, Rust has been voted the most loved language for the past 8 years [[1]](https://survey.stackoverflow.co/2022/#technology-most-loved-dreaded-and-wanted).

The build system or the lack thereof in C/C++, we may either end up making a complicated make file or use CMake neither one of which are very fun to use. We cannot sem-ver control the libraries that we use, right now we need to maintain an archive of the libraries we use in a .zip format, which is rather caveman-esque. With Rust, every crate (or library) lives on [crates.io](https://crates.io/) and follows a semantic versioning system, so no matter when you build or who builds, as long as they have this tiny little Cargo.toml file they will have the same features and functions.

C/C++ lies! What I mean is, Undefined Behaviour and implicit behaviour sometimes the language just does things without telling you. Note how I am able to cause an integer overflow with just a couple of lines of c/c++ code.
```
#include <stdio.h>

int main()
    {
    long long int x = 100000000000000;

    int y = x;

    printf("%lld\n", x);
    printf("%d\n", y);

    return 0;
    }
    // output
    /// 100000000000000
		/// 276447232

   ```

   Now watch what happens with Rust code,
```
fn main()
    {
    let x: u128 = 100000000000000;
    let y:u32 = x;

    println!("x = {}", x);
    println!("y = {}", y);
    }

// output
error[E0308]: mismatched types
 --> src/main.rs:4:17
  |
4 |     let y:u32 = x;
  |           ---   ^ expected `u32`, found `u128`
  |           |
  |           expected due to this
  |
help: you can convert a `u128` to a `u32` and panic if the converted value doesn't fit
  |
4 |     let y:u32 = x.try_into().unwrap();
  |                  ++++++++++++++++++++

For more information about this error, try `rustc --explain E0308`.
error: could not compile `hello` (bin "hello") due to previous error

```
Rust, literally doesn't let you compile!

You might say, "Oh, We're not that dumb, we would never make that mistake" welps, we literally made that mistake causing an integer overflow in the address while writing to the FRAM, [link](https://github.com/USSTR-Avionics/MiniRockets/blob/42a359b2a91f5a51b14c2c35613a7aa832788fcb/CPP_flight_computer_program/src/sensor_fram.cpp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)

And don't even get me started on the keywords, `static` and the scopes of variables, writing code shouldn't be this hard!

As one [redditor](https://www.reddit.com/r/rust/comments/bya8k6/programming_with_rust_vs_c_c/eqfd0xl/) put it,
> If you have a team of people working on C/C++ code you have to make sure they are all very experienced and very careful. When reviewing code you have to be extra detail-oriented, especially for junior folks. Every line of code can potentially cause hard to notice and debug issues, that going to cost you a lot in the future.
> When you have a team working on Rust, you can have bunch of "junior-devs", one senior-Rust dev, to help them out, put `#![forbid(unsafe_code)]` in each crate, and when reviewing code focus on higher-level problems instead of suspiciously staring at each line for UB. Rust compiler is working like free couch for all your devs. The productivity gains are enormous.

Onwards, to more horrible examples! So, at many places in the code base we return macros like EXIT_SUCCESS or EXIT_FAILURE, which I love cause sometimes my dumb brain just doesn't know if 0 is success or a failure or was it 1? ugh! so the macros help with readability, but you see, there is not check or guarantee that the upstream parent that calls on a function that returns EXIT_SUCCESS or EXIT_FAILURE checks if the function was successful or not, but we would NEVER do that I hear you say! welps, look at this [function](https://github.com/USSTR-Avionics/MiniRockets/blob/42a359b2a91f5a51b14c2c35613a7aa832788fcb/CPP_flight_computer_program/src/sensor_bmp280.cpp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) forget checking things upstream we don't even return an EXIT_FAILURE!!! So even if the function fails to do what it is supposed to, we will read it as a success. And check [this](https://github.com/USSTR-Avionics/MiniRockets/blob/master/Software/CPP_flight_computer_program/src/main.cpp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) out where we simply just don't check if the function was successful or not, The solution, Rust's Error and Result types!
```
fn might_fail() -> Result<u8, String>
    {
    Ok(1)
    }

fn main()
    {
    let result = might_fail();

    match result
        {
        Ok(value) => println!("Result is: {}", value),
        Err(error) => println!("Error: {}", error),
        }
    }

```
As you can see above, when you get a result, it is an enum, this enum needs to be explicitly checked for it's success or failure, otherwise, you guessed what happens! The compiler doesn't let you compile the code.

When working on complex systems with many moving parts, every little bit of help from the language helps, and if you haven't noticed, the error messages from the Rust compiler are so incredibly useful, not only do they tell you what you're doing wrong, but most often than not, they tell you how to fix it, wha-?

Furthermore, you can never segfault in Rust, every other c/c++ function, even those in the standard library can segfault.

> C makes it easier to shoot yourself  in the foot, C++ makes it harder but when you do, you blow your whole leg off, while Rust will gently put the gun's safety on, tuck you into bed and spoon you till your fall asleep

We can write perfectly safe C/C++ code but, it requires too much micro-management and hand holding of the programmers to ensure that, Rust allows us to offload all of that to the compiler. Sure, linters exist, but where ever there is a way to disable warnings, programmers will do so. We should build safety nets rather than guard rails.

And as the project gets larger it becomes out of hand to maintain it, with the lack of strong type system and type checking, it becomes so much more harder with the out of control number of include files, with Rust you just put a `pub` in front of the function, or struct. Rust's memory safety, type system, modularity, performance, and tooling make it more maintainable than C++ for large projects. By reducing the likelihood of common programming errors, Rust makes the code more predictable, easier to understand, and more efficient, which translates into lower maintenance costs over time.

# Documentation
## Tools that we will use
- Rust docs
- mdBook for further detailed documentation

## What we will document
1.  System architecture design
2.  Design decisions and trade-offs
3.  Implementation details
4.  User documentation

# Scope
I will concede that a [RIIR](https://transitiontech.ca/random/RIIR) of the whole entire code base is unnecessary and unfeasible, and in an ideal world, I would want the Rust code to be the base from which we cross the FFI boundary to interact with lower level hardware. But, an even better approach is to continue writing our code base in C/C++ while we port parts of it to Rust, things that are fairly stable and not likely to change, for example we could re-write the CAN interface in Rust, or the FRAM interface, or parts of the code base that are mission critical could be Rusty. I personally do not expect anyone to code in Rust or even learn it. But in the grand scheme of things, as more embedded resources become available, Rust is going to be the obvious choice, not to mention the increased adoption in the industry.

# Timeline
The timeline for this project will be as follows:

Week 1-2: Background research and scope definition.
Week 3-4: Define preliminary requirements and identify potential stakeholders.
Week 5-6: Create a detailed project plan and cost analysis.
Week 7-8: Design and implement the system's core features.
Week 9-10: Develop and conduct tests to ensure the system's safety and reliability.
Week 11-12: Document the system's architecture, design decisions, and implementation details.
Week 13-14: Finalize documentation, prepare the project for deployment, and conduct user acceptance testing. Week 15: Deployment and project review.

# Limitations
Some of the potential challenges and their possible solutions are:

1.  Learning curve: Rust has a unique syntax and memory management model, which can be challenging for newcomers. To overcome this challenge, the team can allocate some time for Rust learning sessions, where experienced Rust developers can provide tutorials or code reviews to help new team members get up to speed with the language.

2.  Debugging: Rust is known for its strict compile-time checks, which can help catch bugs before the code runs, but it can also make debugging more challenging. To address this challenge, the team can use Rust's debugging tools, such as gdb and lldb, and use logging and assertions to help identify and fix bugs.

3.  Limited libraries and frameworks: Rust is a relatively new language, and it may not have as many libraries and frameworks as other languages like C++ or Python. To mitigate this challenge, the team can leverage the existing Rust libraries and frameworks, and also consider building custom libraries or modules if needed.

4.  Team communication: If not everyone in the team is familiar with Rust, it may lead to communication challenges during development. To overcome this challenge, the team can use collaboration tools like GitHub, Slack, or Discord to ensure effective communication and knowledge sharing.

5.  Code review and quality assurance: As Rust is a safety-critical language, it's essential to ensure that the code meets high quality and safety standards. The team can implement code review processes, use static code analysis tools, and conduct rigorous testing to ensure that the system is safe and reliable.

In summary, while not everyone in the student-led group may be familiar with Rust, the team can overcome the challenges by dedicating time to Rust learning, using debugging and testing tools, leveraging existing libraries and frameworks, ensuring effective communication, and implementing quality assurance processes.

# Conclusion
The proposed project aims to build a flight computer for a small sounding rocket using the Rust programming language. The use of Rust in avionics projects can provide safety, low-level control, and efficient code generation. The project has the potential to produce a reliable and robust flight computer system, reducing the risks associated with spaceflight activities. The Rust language's safety features, ownership model, and strong typing can help avoid common programming errors, such as null pointer dereferences, buffer overflows, and data races, which can lead to system crashes or vulnerabilities. Furthermore, Rust's support for bare-metal programming makes it well-suited for avionics projects that require direct hardware access. The project's success can also help promote the use of Rust in the aerospace industry, where reliability and safety are critical concerns.

frroossst, 2023-04-02:
I would also like to add, that we could, do the functional or business logic in Rust, while reserving C/C++ for hardware access.

frroossst, 2023-04-02:
Just look at our current statemachine, it is so incredibly easy to get it wrong, you must break or return the control flow in every case of the switch case statement, this is so easy to miss that it is classified as a common vulnerability by the [common weakness enumeration org](https://cwe.mitre.org/data/definitions/484.html), and I don't feel like opening my 214 textbook, but a missing break (or might've been a missing default clause regardless the point still stands) caused a telecom company in the 90s, millions of dollars.

Look at this code, there is no check on the value that can be passed to the arg of type int
```
statemachine_t::e_rocket_state set_current_state_for_statemachine(statemachine_t::e_rocket_state& rs, int state)
	{
	switch (state)
		{
	case 0:
		rs = statemachine_t::e_rocket_state::unarmed;
		return statemachine_t::e_rocket_state::unarmed;
		break;
	case 1:
		rs = statemachine_t::e_rocket_state::ground_idle;
		return statemachine_t::e_rocket_state::ground_idle;
		break;
	case 2:
		rs = statemachine_t::e_rocket_state::powered_flight;
		return statemachine_t::e_rocket_state::powered_flight;
	case 3:
		rs = statemachine_t::e_rocket_state::unpowered_flight;
		return statemachine_t::e_rocket_state::unpowered_flight;
	case 4:
		rs = statemachine_t::e_rocket_state::ballistic_descent;
		return statemachine_t::e_rocket_state::ballistic_descent;
	case 5:
		return statemachine_t::e_rocket_state::chute_descent;
	case 6:
		rs = statemachine_t::e_rocket_state::land_safe;
		return statemachine_t::e_rocket_state::land_safe;
	case 7:
		rs = statemachine_t::e_rocket_state::test_state;
		return statemachine_t::e_rocket_state::test_state;
	default:
		rs = statemachine_t::e_rocket_state::unarmed;
		return statemachine_t::e_rocket_state::unarmed;
		}
	}
```
One small mistake and your rocket is stuck in unarmed mode this could be midflight or perhaps even more catastrophic. Instead, the alternative Rust code *will NOT compile* if the wrong state arg is passed in.
```
pub enum RocketState
    {
    Unarmed,
    GroundIdle,
    PoweredFlight,
    UnpoweredFlight,
    BallisticDescent,
    ChuteDescent,
    Landed,
    }

impl RocketState
    {
    pub fn get_state(&self) -> &str
        {
        match self
            {
            RocketState::Unarmed => "Unarmed",
            RocketState::GroundIdle => "GroundIdle",
            RocketState::PoweredFlight => "PoweredFlight",
            RocketState::UnpoweredFlight => "UnpoweredFlight",
            RocketState::BallisticDescent => "BallisticDescent",
            RocketState::ChuteDescent => "ChuteDescent",
            RocketState::Landed => "Landed",
            }
        }

    pub fn set_state(&mut self, new_state: RocketState)
        {
        *self = new_state;
        }
    }
```

We write horribly incorrect C/C++ code not because we want to, not because we can, not because we're too dumb to foresee the vulnerabilities. All of these are just off the top of my head, I can find half a dozen more if I go digging through the codebase. It's just that it is so so so incredibly easy for programmers to dismiss these potential flaws while they are programming and just want something to work and simply, get it done. And in all honesty it is an unfair expectation to have from a group of volunteer programmers to write strictly safe code.

Oh! and if you think we can simply use compiler warnings to help us with stuff like this, well some of this stuff still won't be caught, like the FRAM bug, or array out of bounds indexing. But, we will be buried in warnings, if you dig deep enough you will find a commit that is me just adding the `#pragma GCC` directive to suppress warnings coming from the libraries that we use. The libraries we use, which are written by senior C++ programmers are still vulnerable and not upto code guidelines and specifications. It is not us the programmers, but rather the language itself that is the root of this issue, hence, my push for using a different language.

dhaussecker, 2023-04-06:
After review of the proposal, this project has been rejected under the following concerns:
- It is our number one priority for us to be designing the simplest method possible, after review of all alternatives it has been determined that this proposal violates this priority and would complicate our design
- There is now a limited amount of time for us to get done what needs to get done (12 months). We do not have time to be “fixing things that aren’t broke” at this stage of the project
- The team as a whole has made a decision that they do not want to be working on such a project. The decision has been made to continue with the way we are developing in C/C++

Closed 2023-04-06.
