USSTR-Avionics/MiniRockets/Hardware/Mini_Rocket_V2/Mini_Rocket_V2.pdf

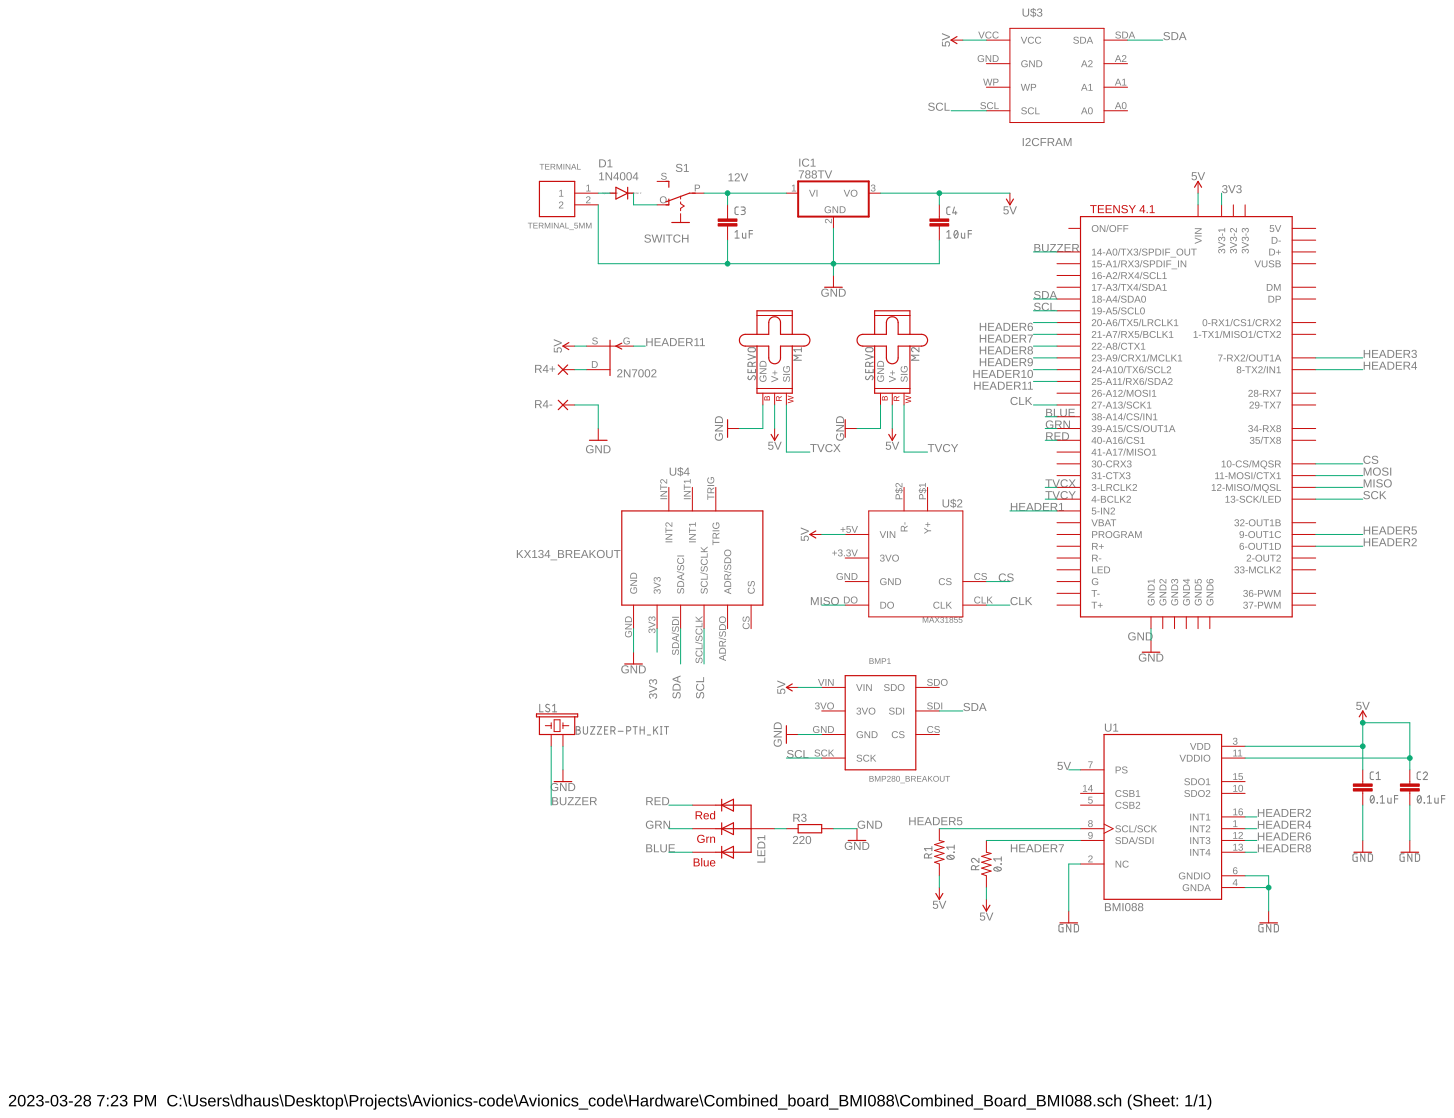
[picture p1: page 1]
