USSTR-Avionics/MiniRockets/Hardware/Mini_Rocket_V1/Mini_Rocket_V1.pdf

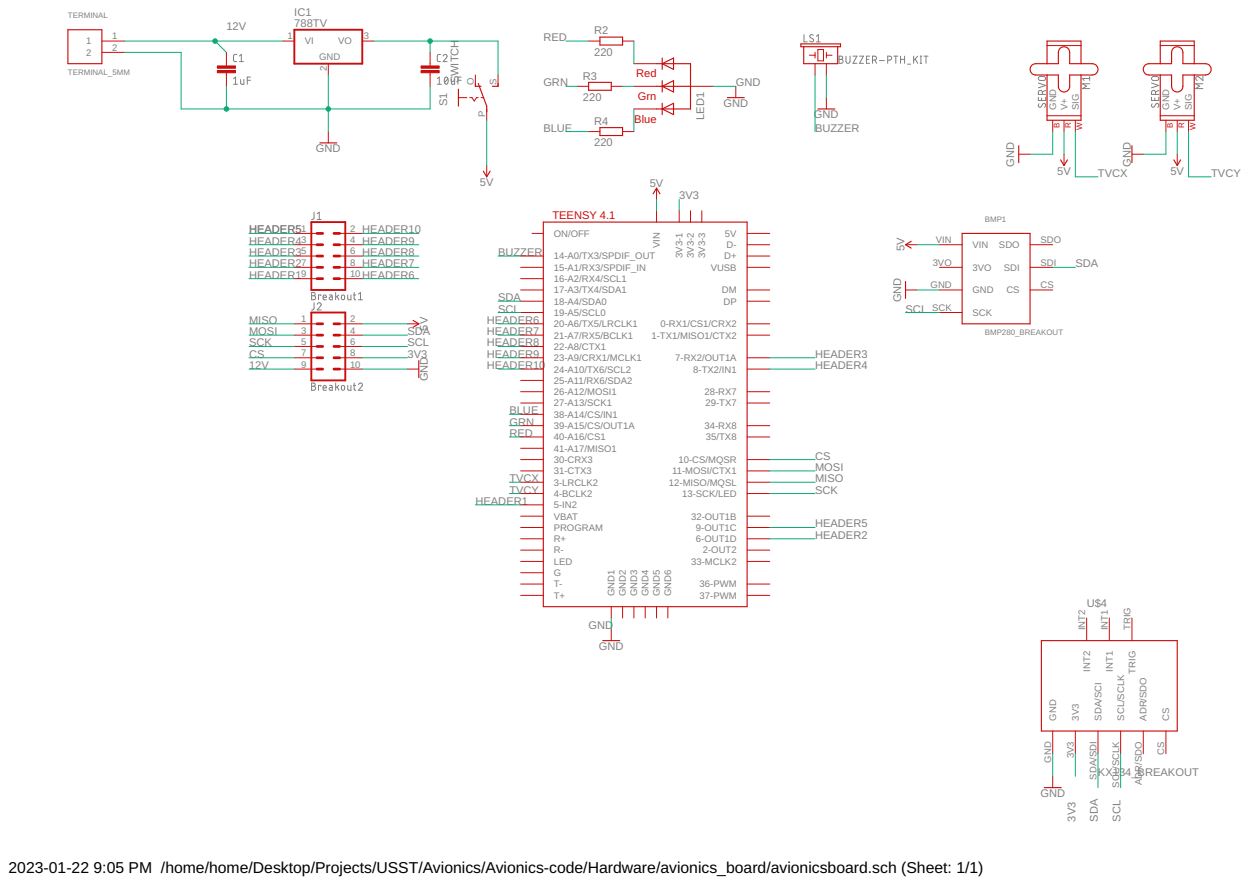
[picture p2: page 1]

3V3 SDA/SCI SDA/SDI SCL/SCLK

2023-01-22 9:05 PM /home/home/Desktop/Projects/USST/Avionics/Avionics-code/Hardware/avionics_board/avionicsboard.sch (Sheet: 1/1)
