USSTR-Avionics/MiniRockets/Hardware/Mini_Rocket_V1/Mini_Rocket_V1.brd

## EAGLE design Hardware/Mini_Rocket_V1/Mini_Rocket_V1.brd (2023-02-05, an earlier design)

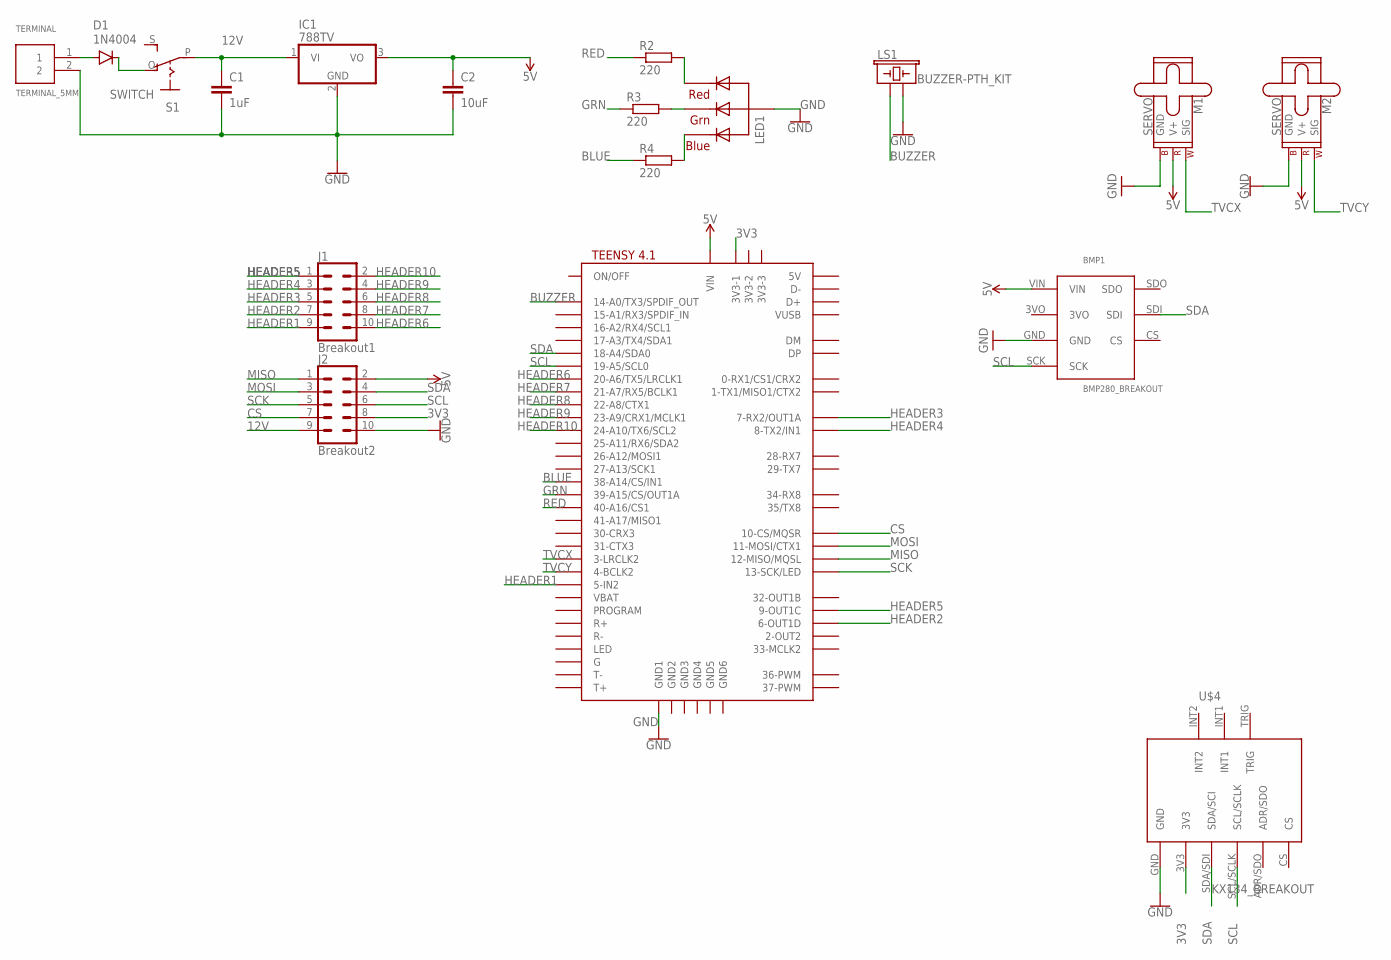
[picture p3: schematic Mini_Rocket_V1.sch]

Parts:
BMP1: BMP280_BREAKOUT
C1: 1uF; CAP-PTH-2.54
C2: 10uF; CAP-PTH-2.54
D1: 1N4004; DO41-10
IC1: 788TV; TO220V
J1: Breakout1; 2X5_NOSILK
J2: Breakout2; 2X5_NOSILK
LED1: RGBLED_CA-5MM; LED5MMRGB
LS1: BUZZER-PTH_KIT; BUZZER-12MM-KIT
M1, M2: SERVO; 1X03
R2, R3, R4: 220; 0204/7
S1: SWITCH; EG1218
TERMINAL: TERMINAL_5MM
U$1: TEENSY41
U$4: KX134_BREAKOUT

Connections:
3V3: J2.8, U$1.3V3-1, U$4.3V3
5V: BMP1.VIN, C2.1, IC1.3 (VO), J2.2, M1.2 (V+), M2.2 (V+), U$1.VIN
12V: C1.1, IC1.1 (VI), J2.9, S1.P
BLUE: R4.1, U$1.38-A14/CS/IN1
BUZZER: LS1.+ (1), U$1.14-A0/TX3/SPDIF_OUT
CS: J2.7, U$1.10-CS\MQSR (10-CS/MQSR)
GND: BMP1.GND, C1.2, C2.2, IC1.2 (GND), J2.10, LED1.2 (VCC), LS1.- (2), M1.3 (GND), M2.3 (GND), TERMINAL.2, U$1.GND1, U$4.GND
GRN: R3.1, U$1.39-A15/CS/OUT1A
HEADER1: J1.9, U$1.5-IN2
HEADER2: J1.7, U$1.6-OUT1D
HEADER3: J1.5, U$1.7-RX2/OUT1A
HEADER4: J1.3, U$1.8-TX2/IN2 (8-TX2/IN1)
HEADER5: J1.1, U$1.9-OUT1C
HEADER6: J1.10, U$1.20-A6/TX5/LRCLK1
HEADER7: J1.8, U$1.21-A7/RX5/BCLK1
HEADER8: J1.6, U$1.22-A8/CTX1
HEADER9: J1.4, U$1.23-A9/CRX1/MCLK1
HEADER10: J1.2, U$1.24-A10/TX6/SCL2
MISO: J2.1, U$1.12-MISO/MQSL
MOSI: J2.3, U$1.11-MOSI/CTX1
unnamed: LED1.1 (RED), R2.2
unnamed: LED1.3 (GREEN), R3.2
unnamed: LED1.4 (BLUE), R4.2
unnamed: D1.A, TERMINAL.1
unnamed: D1.C, S1.O
RED: R2.1, U$1.40-A16/CS1
SCK: J2.5, U$1.13-SCK/LED
SCL: BMP1.SCK, J2.6, U$1.19-A5/SCL0, U$4.SCL/SCLK
SDA: BMP1.SDI, J2.4, U$1.18-A4/SDA0, U$4.SDA/SDI (SDA/SCI)
TVCX: M1.1 (SIG), U$1.3-LRCLK2
TVCY: M2.1 (SIG), U$1.4-BCLK2

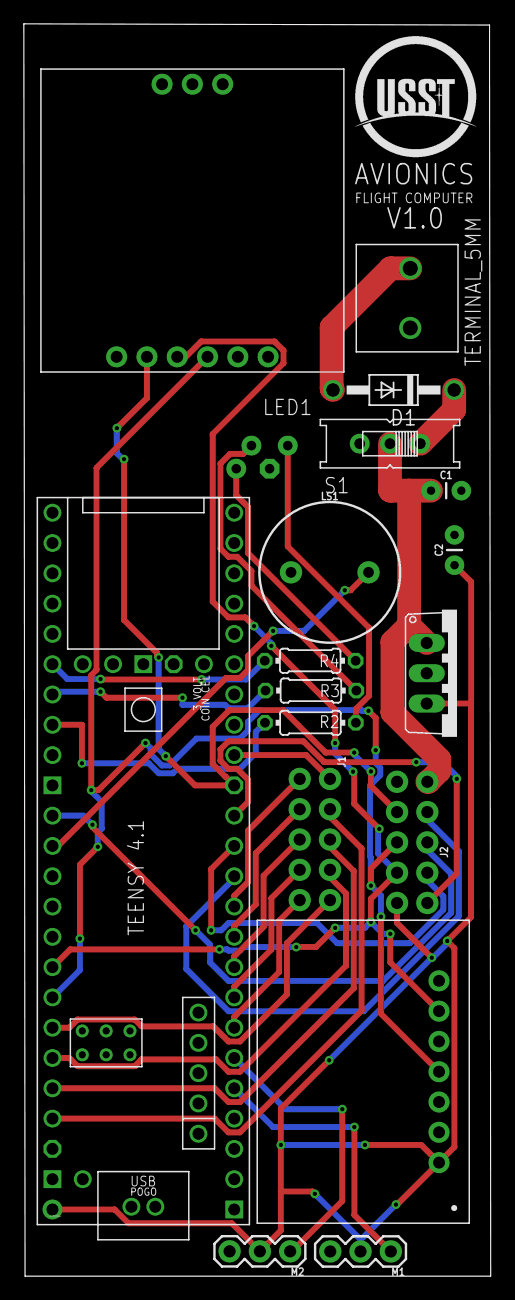
[picture p4: board Mini_Rocket_V1.brd from above]

Board: 2 copper layers, 39.1 x 105.0 mm, 18 parts (1 on the bottom side), 31 nets.
