USSTR-Avionics/MiniRockets/Hardware/Mini_Rocket_V2/Mini_Rocket_V2.brd

## EAGLE design Hardware/Mini_Rocket_V2/Mini_Rocket_V2.brd (2023-03-07)

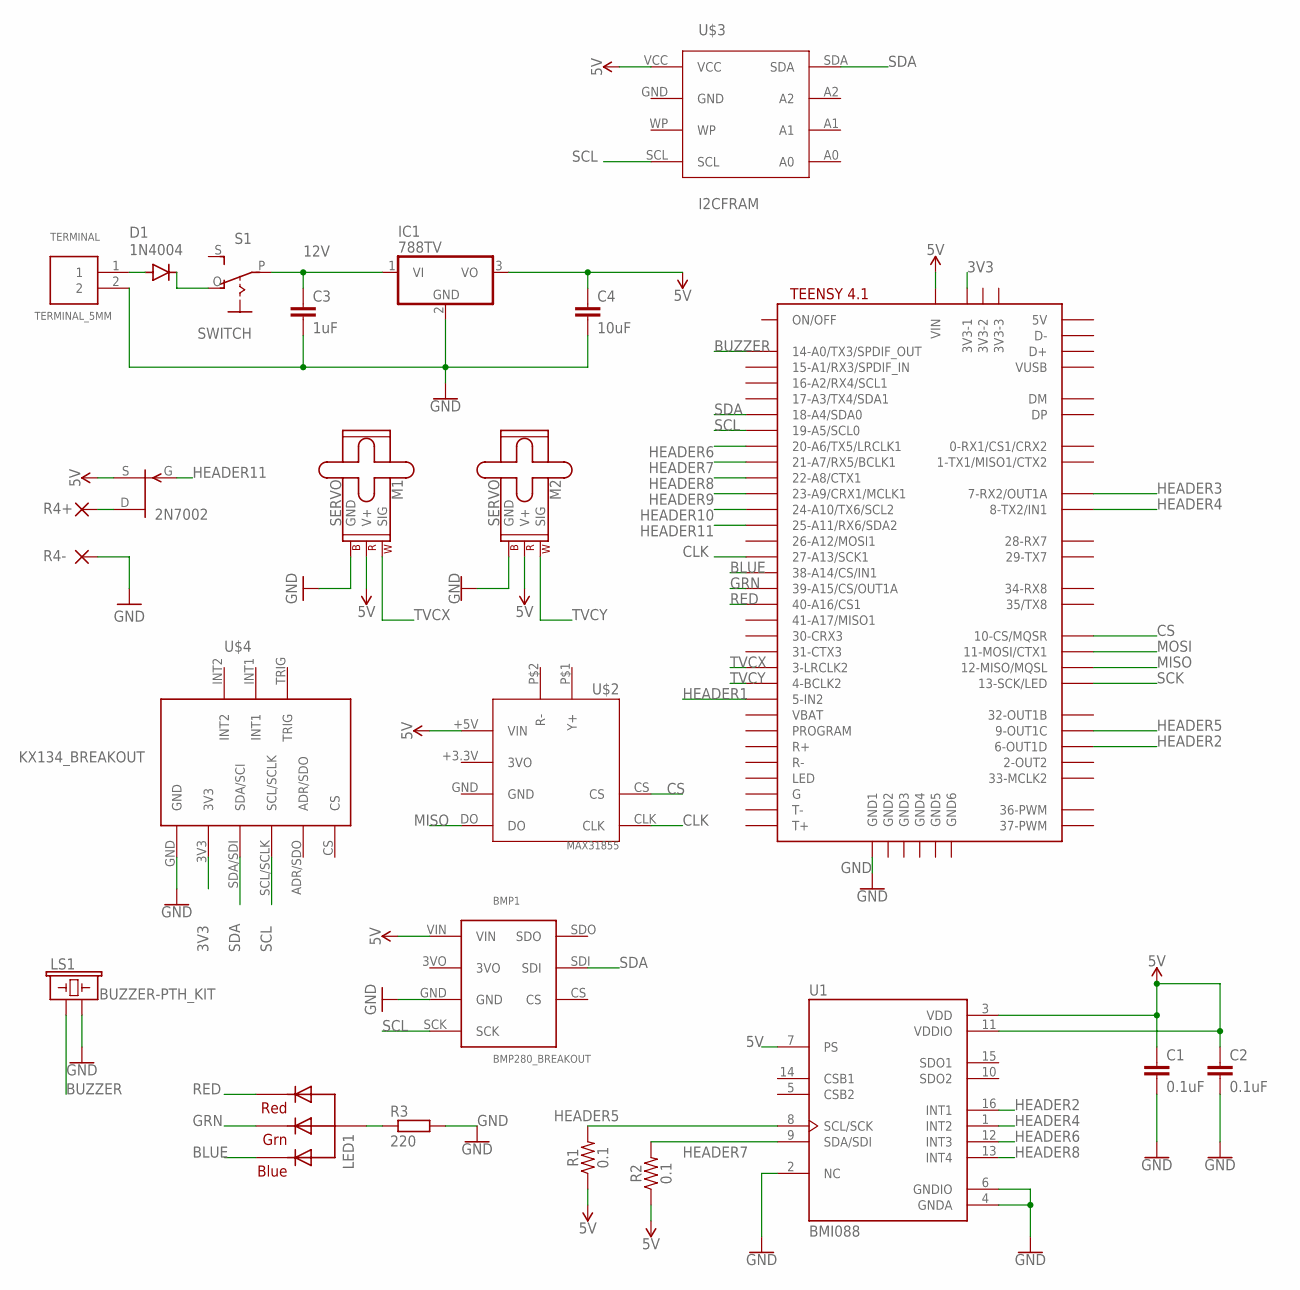
[picture p5: schematic Mini_Rocket_V2.sch]

Parts:
2N7002: 2N3819; TO92
BMP1: BMP280_BREAKOUT
C1, C2: 0.1uF; 0402
C3: 1uF; CAP-PTH-2.54
C4: 10uF; CAP-PTH-2.54
D1: 1N4004; DO41-10
IC1: 788TV; TO220V
LED1: RGBLED_CA-5MM; LED5MMRGB
LS1: BUZZER-PTH_KIT; BUZZER-12MM-KIT
M1, M2: SERVO; 1X03
R1, R2: 0.1; 0603
R3: 220; 0204/7
R4+, R4-: 1,6/0,8
S1: SWITCH; EG1218
TERMINAL: TERMINAL_5MM
U1: BMI088; PQFN50P450X300X100-16N
U$1: TEENSY41
U$2: MAX31855; MAX31855-BREAKOUT
U$3: I2CFRAM
U$4: KX134_BREAKOUT

Connections:
3V3: U$1.3V3-1, U$4.3V3
5V: 2N7002.3 (S), BMP1.VIN, C1.1, C2.1, C4.1, IC1.3 (VO), M1.2 (V+), M2.2 (V+), R1.1, R2.1, U1.3 (VDD), U1.7 (PS), U1.11 (VDDIO), U$1.VIN, U$2.+5V (VIN), U$3.VCC
12V: C3.1, IC1.1 (VI), S1.P
BLUE: LED1.4 (BLUE), U$1.38-A14/CS/IN1
BUZZER: LS1.+ (1), U$1.14-A0/TX3/SPDIF_OUT
CLK: U$1.27-A13/SCK1, U$2.CLK
CS: U$1.10-CS\MQSR (10-CS/MQSR), U$2.CS
GND: BMP1.GND, C1.2, C2.2, C3.2, C4.2, IC1.2 (GND), LS1.- (2), M1.3 (GND), M2.3 (GND), R3.2, R4-.1, TERMINAL.2, U1.2 (NC), U1.4 (GNDA), U1.6 (GNDIO), U$1.GND1, U$4.GND
GRN: LED1.3 (GREEN), U$1.39-A15/CS/OUT1A
HEADER1: U$1.5-IN2
HEADER2: U1.16 (INT1), U$1.6-OUT1D
HEADER3: U$1.7-RX2/OUT1A
HEADER4: U1.1 (INT2), U$1.8-TX2/IN2 (8-TX2/IN1)
HEADER5: R1.2, U1.8 (SCL/SCK), U$1.9-OUT1C
HEADER6: U1.12 (INT3), U$1.20-A6/TX5/LRCLK1
HEADER7: R2.2, U1.9 (SDA/SDI), U$1.21-A7/RX5/BCLK1
HEADER8: U1.13 (INT4), U$1.22-A8/CTX1
HEADER9: U$1.23-A9/CRX1/MCLK1
HEADER10: U$1.24-A10/TX6/SCL2
HEADER11: 2N7002.2 (G), U$1.25-A11/RX6/SDA2
MISO: U$1.12-MISO/MQSL, U$2.DO
MOSI: U$1.11-MOSI/CTX1
unnamed: LED1.2 (VCC), R3.1
unnamed: D1.A, TERMINAL.1
unnamed: 2N7002.1 (D), R4+.1
unnamed: D1.C, S1.O
RED: LED1.1 (RED), U$1.40-A16/CS1
SCK: U$1.13-SCK/LED
SCL: BMP1.SCK, U$1.19-A5/SCL0, U$3.SCL, U$4.SCL/SCLK
SDA: BMP1.SDI, U$1.18-A4/SDA0, U$3.SDA, U$4.SDA/SDI (SDA/SCI)
TVCX: M1.1 (SIG), U$1.3-LRCLK2
TVCY: M2.1 (SIG), U$1.4-BCLK2

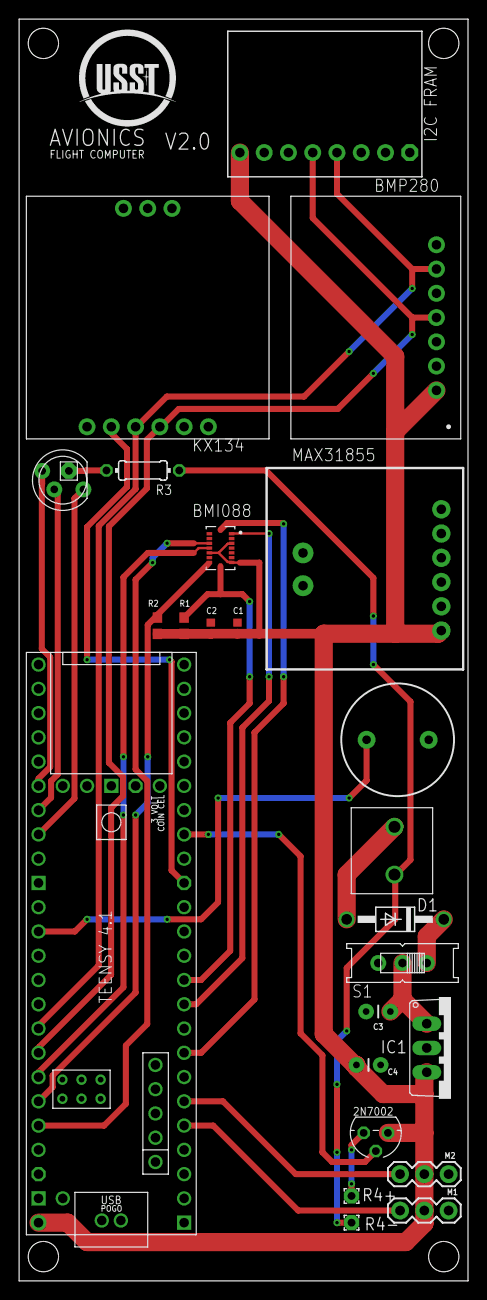
[picture p6: board Mini_Rocket_V2.brd from above]

Board: 2 copper layers, 47.0 x 132.1 mm, 24 parts (0 on the bottom side), 26 nets.
