USSTR-Avionics/MiniRockets/Hardware/BMI088_Breakout/BMI088_Breakout.brd

## EAGLE design Hardware/BMI088_Breakout/BMI088_Breakout.brd (2023-01-22)

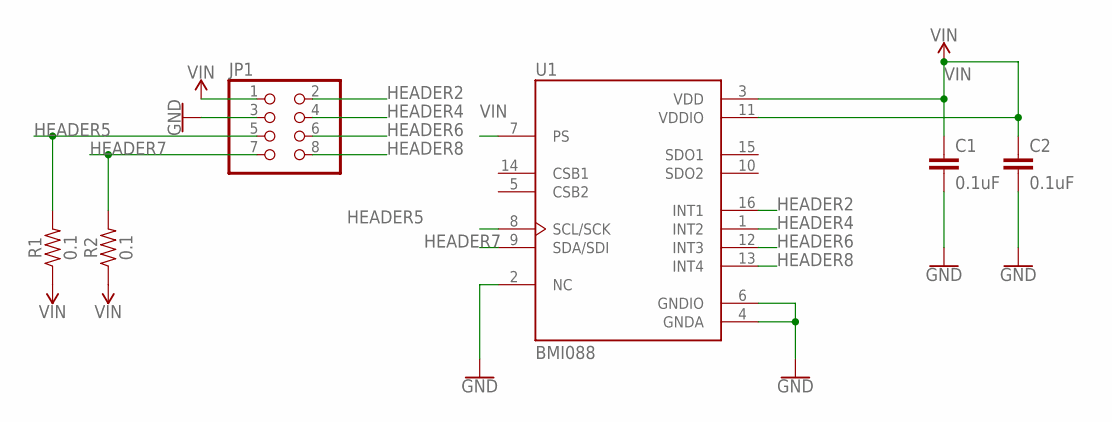
[picture p7: schematic BMI088_Breakout.sch]

Parts:
C1, C2: 0.1uF; 0402
JP1: PINHD-2X4; 2X04
R1, R2: 0.1; 0603
U1: BMI088; PQFN50P450X300X100-16N

Connections:
GND: C1.2, C2.2, JP1.3, U1.2 (NC), U1.4 (GNDA), U1.6 (GNDIO)
HEADER2: JP1.2, U1.16 (INT1)
HEADER4: JP1.4, U1.1 (INT2)
HEADER5: JP1.5, R1.2, U1.8 (SCL/SCK)
HEADER6: JP1.6, U1.12 (INT3)
HEADER7: JP1.7, R2.2, U1.9 (SDA/SDI)
HEADER8: JP1.8, U1.13 (INT4)
VIN: C1.1, C2.1, JP1.1, R1.1, R2.1, U1.3 (VDD), U1.7 (PS), U1.11 (VDDIO)

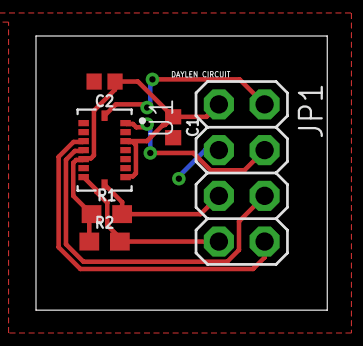
[picture p8: board BMI088_Breakout.brd from above]

Board: 2 copper layers, 16.2 x 15.2 mm, 6 parts (0 on the bottom side), 8 nets.
