USSTR-Avionics/MiniRockets/Software/CPP_flight_computer_program/include/sensor_pins.h

#ifndef SENSOR_PINS_H_
#define SENSOR_PINS_H_

// define all pins here so that it is easier to change them

// LED pins
#define LED_BLUE      38
#define LED_GREEN     39
#define LED_RED       40

// Buzzer pins
#define BUZZER_PIN    14

// Thermocouple pins
#define MAXDO         12
#define MAXCS         10
#define MAXCLK        27

// Parachute pins
#define PARACHUTE_PIN 25


#endif // SENSOR_PINS_H_
