USSTR-Avionics/MiniRockets/Software/CPP_flight_computer_program/src/sensor_parachute.cpp

#include "sensor_pins.h"
#include <Arduino.h>


/**
 * @brief    deploy the parachute
 * @post     the parachute is deployed
 */
void deploy_parachute()
	{
	// pinMode(PARACHUTE_PIN, OUTPUT);
	// digitalWrite(PARACHUTE_PIN, HIGH);
	digitalWrite(PARACHUTE_PIN, LOW);
	}
