USSTR-Avionics/MiniRockets/Software/CPP_flight_computer_program/src/sensor_buzzer.cpp

#include "sensor_buzzer.h"
#include "sensor_pins.h"

#include <Arduino.h>

/**
 * @brief  turn on the buzzer
 * @note   this WILL annoy the shit out of you
 */
void buzzer_on()
	{
	int melody[] = { NOTE_CS5, NOTE_DS5, NOTE_FS5 };
	int duration = 500;
	// We only use melody[1] here to not have too long of a delay
	// pin8 output the voice, every scale is 0.5 sencond
	tone(BUZZER_PIN, melody[1], duration);
	}

/**
 * @brief  turn off the buzzer
 */
void buzzer_off()
	{
	digitalWrite(BUZZER_PIN, LOW);
	}
