USSTR-Avionics/MiniRockets/Software/CPP_flight_computer_program/src/sensor_radio.cpp

#include "sensor_sdcard.h"
#include "statemachine_t.h"

void get_start_signal_from_ground_station(statemachine_t::e_rocket_state& rs)
	{
	// TODO: write code to await a signal from radio!
	rs = statemachine_t::ground_idle;
	}
