USSTR-Avionics/MiniRockets/Software/CPP_flight_computer_program/include/sensor_ms5611.h

#ifndef SENSOR_MS5611_H
#define SENSOR_MS5611_H

#include "default_variables.h"

float ms5611_temp                 = FLO_DEF;
float ms5611_press                = FLO_DEF;
float ms5611_ground_base_pressure = FLO_DEF;

bool init_MS5611();
float get_ms5611_temp();
float get_ms5611_press();
float get_ms5611_altitude(float pressure, float seaLevelPressure);

#endif // SENSOR_MS5611_H
