USSTR-Avionics/MiniRockets/Software/CPP_flight_computer_program/include/package_watchdog.h

#ifndef PACKAGE_WATCHDOG_H
#define PACKAGE_WATCHDOG_H

#include "Watchdog_t4.h"

WDT_T4<WDT2> wdt;
WDT_timings_t config;

#define WATCHDOG_TRIGGER 3.0f // seconds
#define WATCHDOG_TIMEOUT 6.0f // seconds

void watchdog_callback();

#endif // PACKAGE_WATCHDOG_H
