USSTR-Avionics/MiniRockets/(commit log)

2022-01-01 Added flight computer code to control the sensor modules
2022-01-02 Added LED Module with BLUE, GREEN, RED Functionality
2022-01-04 added Buzzer module and LED module to overall flight_computer template
2022-01-04 Update flight_computer_template.ino
    Uncommented buzzerOn() function in groundIdle state
2022-01-04 Added camera module placeholder comments
2022-01-05 fixed broken temperature sensor code and added TODO statement for calculations still required to be done
2022-01-05 Added correct pins to teensy mcu
2022-01-14 added imu module, with calibration code, but the calibration process is still not implemented in the module
2022-01-22 Remade the imu module without a libary based on datasheet specifications
2022-05-01 fixed led code
2022-05-21 basic serial monitor logging for kx134 3axis acc breakout sensor
2022-06-05 ground station temp sensor and logging w/ pi and DHT 11
2022-06-11 accel sensor import thingy
2022-06-25 Added acceleration, imu, and pressure sensor module functionality
2022-07-08 Kalman filter starting code
2022-07-09 Added 1D Constant Dynamic Kalman Filter
2022-07-11 Added multidimenstional kalman filter for altitude starter code
2022-07-23 working multidimensional kalman filter for acceleration
2022-10-01 0.1.0 - added code for ms5611, readings stuck at -9.99
    [main.cpp, sensor_ms5611.cpp, sensor_ms5611.h]
2022-10-01 0.1.1 - temp sensors now work!
2022-10-19 added tests for fram wrapper for temp, and started working on sensor chunk memory layout
2022-10-20 added i2c fram lib, yet to integrate
2022-10-22 added pcb mini-rocket design
    [avionicsboard.brd, avionicsboard.sch]
2022-10-23 Added store function in case of variable going out of scope and losing data
2022-10-23 added watchdog lib for Teensy
2022-10-30 working on float representation in memory
    [avionicsboard.brd, avionicsboard.sch]
2022-10-31 mostly in sync with .ino code except for kalman filters, added preflight software checklist
2022-11-02 FLODEF changed to not move into powered flight on rest
2022-11-07 added i2c scanner, bmp280 returns no data
2022-11-07 sd does not work because builtin_sd macro not in lib
    [main.cpp, sensor_sdcard.cpp]
2022-11-08 added support for external LED
2022-11-11 0.5.0 - changed delays back to millis
2022-11-19 added eagle files
    [avionicsboard.brd, avionicsboard.sch, good.brd, good.sch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]
2022-12-02 0.8.1 - fixed const char * declaration in header
    [main.cpp, sensor_sdcard.cpp, sensor_sdcard.h]
2022-12-02 0.8.3 - fixed csv formatting
    [main.cpp]
2022-12-24 Changed how serial data was printed out in flight (only have comma delimited values in the serial output if not in debug)
2022-12-24 Fixed ground idle to powered flight flawed transition state
    [main.cpp]
2022-12-24 Fixed flawed transition from powered to unpowered flight. When acceleration < Liftoff_threshold it should transition to next state, also flawed implementation of millis() time check is fixed
    [main.cpp]
2022-12-24 0.8.5 - changes that Dylan made
    [avionicsboard.brd, avionicsboard.sch, good.brd, good.sch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]
2022-12-26 modified led pins and added buzzer module
    [main.cpp, sensor_buzzer.cpp, sensor_buzzer.h, sensor_led.cpp]
2022-12-28 Cleaned up code, added a test mode which currently allows the program to enter any state for testing purposes, made .h file for user variables that can be edited depending on what the user wants to t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
2022-12-31 updated state machine with MS5611 sensor rather than BMP280 since we are out of BMP280's
2023-01-15 state transition uses a switch case statement now
2023-01-15 fixed ODR violations; do not declare globals in header files!
    [main.cpp]
2023-01-16 break i2c scanner into a debug header
2023-01-16 added additional checks to prevent accidental production builds
    [main.cpp, package_statemachine_t.cpp, package_testmode.h]
2023-01-21 testing a build fail
    [package_testmode.h]
2023-01-21 renamed folders
    [avionicsboard.brd, avionicsboard.sch, good.brd, good.sch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]
2023-01-22 trying to unfuck dev
    [avionicsboard.brd, avionicsboard.sch, good.brd, good.sch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]
2023-01-22 unfucking with a PR, maybe?! (#41)
    * Work in progress test class
    * update Test.cpp
    * removed async test
    * Removed test.h
    * removed test.cpp
    * Test now take in function name
    * added FRAM_test to test out some c++ stuff
    * added played with virutal methods and operator overloading
    * removed cpp version check
    * Added store function in case of variable going out of scope and losing data
    * Cleaned up unnecessary virutal methods
    * removed unnecessary this-> pointer
    * Update todo
    * Update todo
    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
2023-01-22 merge to master (#42)
    * implemented half of the `read()`, pretty sure doesn't work tho
    * Updated .gitignore
    * Updated .gitignore
    * Bug fix
    * Placed enum into namespace, shouldn't cause troub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
2023-01-23 tested initial framework, added avionics schematic
2023-01-23 added include guards, native testing causes problem with embedded headers
    [package_fram.cpp, package_testmode.h, sensor_buzzer.cpp, sensor_buzzer.h, sensor_ms5611.cpp]
2023-01-25 fram changes and adding pio test (#43)
    * removed rust wrapper for fram
    * added link to testing, removed rust code
    * tested initial framework, added avionics schematic
    * added include guards, native testing causes problem with embedded headers
    * cannot build on native
    * working on fram wrapping in cpp
    * removed desktop test, restructed fram wrapper
    * fram structure changes
    [main.cpp, package_fram.cpp, package_fram.h, package_testmode.h, sensor_buzzer.cpp, sensor_buzzer.h, sensor_fram.cpp]
2023-01-25 Dev (#44)
    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
2023-01-28 code kinda gets stuck
    [main.cpp, sensor_fram.cpp, test_main.cpp]
2023-01-30 fixed variable shadowing for globals in func param
    [sensor_bmp280.cpp]
2023-01-31 fixed accl bug and more
    [debug_macros.h, main.cpp, package_fram.cpp, sensor_fram.h, sensor_kx134.cpp]
2023-02-01 fixed extern declaration of apogee buffer
    [main.cpp, sensor_bmp280.h]
2023-02-03 i2c scanner doesn't work, fram not picked up on i2c scan
    [debug_I2C_Scanner.cpp, debug_I2C_Scanner.h, main.cpp, sensor_fram.cpp]
2023-02-05 Created combined board folder and created schematic and board files for combined board (#49)
    * test
    * nominal
    * Combined Avionics board and BMI088 board into on PCB named Combined Board, added space for plunger to fit around the combined board. Changed Avionics board to include a diode and power switch.
    ---------
    [Combined_Board.brd, Combined_Board.sch, avionicsboard.brd]
2023-02-05 eliminated warnings from sensor_sdcard
2023-02-11 Made write and read temperature work (#54)
2023-02-11 added mosfets to combine boards (#56)
    * added mosfet to combine boards
    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
    [Combined_Board.brd, Combined_Board.sch]
2023-02-12 Added thermocouple code, no servo code (#55)
    * Added servo code and library
    * Updated servo code
    * Added thermocouple Header and cpp file
    * Added thermocouple Header and cpp file without servo code this time
    * Added thermocouple Header and cpp file without servo code this time and it compiles
    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
2023-02-12 fixed compilation error in package_fram
    [package_fram.cpp]
2023-02-18 i tested around the code, commented out switch mode in RFM95.cpp and it seem to work untill my usb stop letting me upload code :))))
2023-02-19 type on Reset in main
    [main.cpp]
2023-02-23 fram dump is now controlled by an external pin
2023-02-23 0.10.0 - fram dump doesn't look exactly right
    [main.cpp, package_fram.cpp]
2023-02-26 0.10.2 - added LED and Buzzer pin and they work
    [debug_I2C_Scanner.h, main.cpp, package_fram.cpp, sensor_buzzer.cpp, sensor_buzzer.h, sensor_kx134.cpp, sensor_pins.h]
2023-03-01 Class is now functioning, need to clean up. - radio.init() must be called inside the main file after being manually resetted, any other attempt at working around this has failed (including creating R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
    [main.cpp]
2023-03-02 fixed RAII resulting in dangling ptr
    [main.cpp]
2023-03-04 Dylan sucks (#59)
    * Updated flight computer to new version for mini rockets
    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
    [Combined_Board.brd, Combined_Board.sch, Combined_Board_BMI088.brd, Combined_Board_BMI088.sch]
2023-03-05 should not crash and send messages now
    [main.cpp]
2023-03-18 fram problem fixed! Switched 8bit -> 16bit (#67)
    [sensor_fram.cpp, sensor_fram.h, test_main.cpp]
2023-03-29 Organized repository to be more neat
    [BMI088_Breakout.brd, BMI088_Breakout.sch, Combined_Board.brd, Combined_Board.sch, Mini_Rocket_V1.brd, Mini_Rocket_V1.sch, Mini_Rocket_V2.brd, Mini_Rocket_V2.sch]
2023-04-01 UDP send no send but crash
    [main.cpp]
2023-04-01 no print current state fram
2023-04-01 wrks nt
    [output.csv]
2023-04-08 1.0.0 - DO NOT FUCKING TOUCHgit log --oneline!
    [output.csv]
2023-04-15 1.1.0 - pin layout changes, yet to be tested
    [output.csv]
2023-04-24 1.1.1 - changes requested by Dylan to set pin to LOW on parachute deploy
2023-04-27 1.1.2 - added a parachute timer to burn the resistor for only 7 seconds
    [main.cpp, sensor_parachute.cpp]
